DanielBaur/useless_box/images/3_4__close_up_.jpg

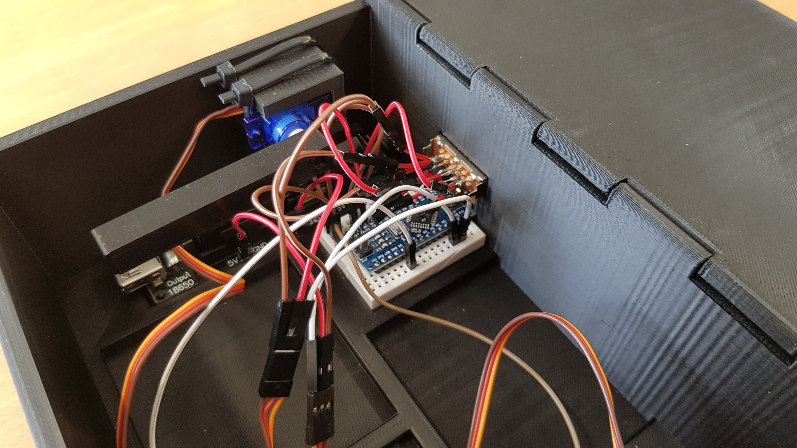
images/3_4__close_up_.jpg
