DanielBaur/useless_box/images/daniele_tartaglia__circuit_scheme_1.png

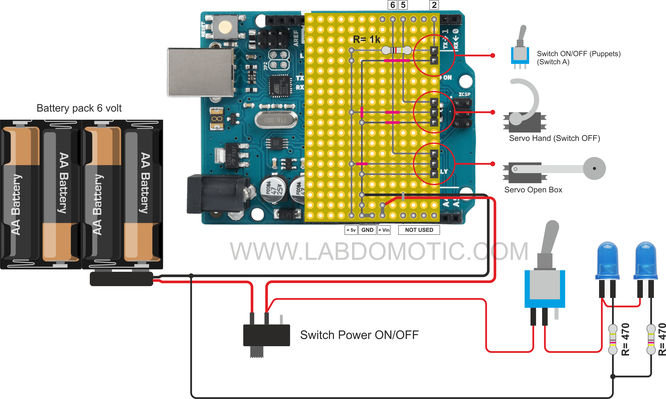
images/daniele_tartaglia__circuit_scheme_1.png
