DanielBaur/useless_box/images/daniele_tartaglia__circuit_scheme_2.png

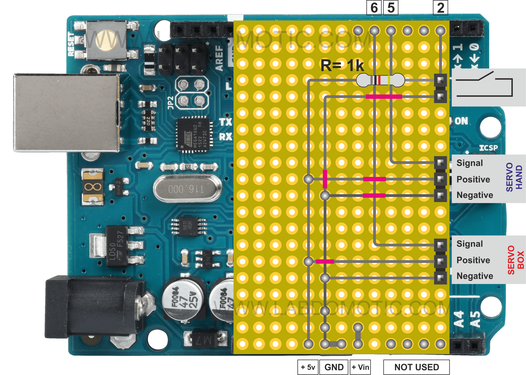
images/daniele_tartaglia__circuit_scheme_2.png
