DanielBaur/useless_box/PUPPETS_UselessBox/PUPPETS_UselessBox.ino

/* www.labdomotic.com
Youtube channel TARTAGLIA DANIELE
*/

#include <Servo.h>                        //Inserisci libreria del servo
Servo handServo;
Servo boxServo;

int switchAnimazione = 0, action = 1, vot, randNumber = 0;
const int InterruttorePorta = 2;
const int ServoManoPin = 5;
const int ServoAperturaBoxPin = 6;


void setup()
{
  Serial.begin(9600);
  handServo.attach(ServoManoPin);
  boxServo.attach(ServoAperturaBoxPin);
  handServo.write(180);   //Posizione di partenza del servomotore Mano
  boxServo.write(70);    //Posizione di partenza del servomotore che apre la scatola
}


void loop()
{
  switchAnimazione = digitalRead(InterruttorePorta);


  // ----------------------------------------------------------------------------------------------------------------------------
  // -------------------------------                  PRIMA ANIMAZIONE                -------------------------------------------
  // ----------------------------------------------------------------------------------------------------------------------------
  // ----------------------------------------------------------------------------------------------------------------------------

  if (switchAnimazione == LOW) {

    if (action == 1)
    {
      for (int i = 70; i <= 110; i++)
      {
        boxServo.write(i);
        delay(13);
      }
      for (int i = 180; i >= 35; i--)
      {
        handServo.write(i);
        delay(20);
      }
      delay(1000);
      handServo.write(26);
      delay(200);
      for (int i = 26; i <= 180; i++)
      {
        handServo.write(i);
        delay(20);
      }
      for (int i = 110; i >= 70; i--)
      {
        boxServo.write(i);
        delay(20);
      }
      action++;
    }

    // ----------------------------------------------------------------------------------------------------------------------------
    // -------------------------------                  SECONDA ANIMAZIONE                -----------------------------------------
    // ----------------------------------------------------------------------------------------------------------------------------
    // ----------------------------------------------------------------------------------------------------------------------------


    else if (action == 2)
    {
      for (int i = 70; i <= 110; i++) {
        boxServo.write(i);
        delay(6);
      }
      delay(550);
      handServo.write(26);
      delay(550);
      handServo.write(180);
      delay(550);
      boxServo.write(70);
      delay(1500);
      for (int i = 70; i <= 110; i++) {
        boxServo.write(i);
        delay(6);
      }
      delay(3000);
      boxServo.write(70);
      action++;
    }

    // ----------------------------------------------------------------------------------------------------------------------------
    // -------------------------------                  TERZA ANIMAZIONE                -------------------------------------------
    // ----------------------------------------------------------------------------------------------------------------------------
    // ----------------------------------------------------------------------------------------------------------------------------



    else if (action == 3)
    {
      Serial.println("Action 3");
      for (int i = 70; i <= 110; i++) {
        boxServo.write(i);
        delay(6);
      }
      delay(1000);
      boxServo.write(70);
      delay(2000);
      for (int i = 70; i <= 110; i++) {
        boxServo.write(i);
        delay(6);
      }
      handServo.write(26);
      delay(550);
      handServo.write(180);
      delay(500);
      boxServo.write(70);
      action++;
    }

    // ----------------------------------------------------------------------------------------------------------------------------
    // -------------------------------                  QUARTA ANIMAZIONE                ------------------------------------------
    // ----------------------------------------------------------------------------------------------------------------------------
    // ----------------------------------------------------------------------------------------------------------------------------



    else if (action == 4)
    {
      Serial.println("Action 4");
      for (int i = 70; i <= 110; i++)
      {
        boxServo.write(i);
        delay(20);
      }
      for (int i = 180; i >= 35; i--)
      {
        handServo.write(i);
        delay(20);
      }
      delay(2000);
      handServo.write(26);
      delay(200);
      handServo.write(180);
      delay(400);
      boxServo.write(70);
      action++;
    }


    // ----------------------------------------------------------------------------------------------------------------------------
    // -------------------------------                  QUINTA ANIMAZIONE                ------------------------------------------
    // ----------------------------------------------------------------------------------------------------------------------------
    // ----------------------------------------------------------------------------------------------------------------------------


    else if (action == 5)
    {
      Serial.println("Action 5");
      for (int i = 70; i <= 110; i++) {
        boxServo.write(i);
        delay(6);
      }
      delay(2000);
      handServo.write(65);
      delay(550);
      handServo.write(40);
      delay(200);
      handServo.write(65);
      delay(200);
      handServo.write(40);
      delay(200);
      handServo.write(65);
      delay(200);
      handServo.write(40);
      delay(200);
      handServo.write(65);
      delay(200);
      handServo.write(40);
      delay(200);
      handServo.write(65);
      delay(200);
      handServo.write(40);
      delay(200);
      handServo.write(65);
      delay(2000);
      handServo.write(26);
      delay(400);
      handServo.write(180);
      delay(400);
      boxServo.write(70);
      action++;
    }


    // ----------------------------------------------------------------------------------------------------------------------------
    // -------------------------------                  SESTA ANIMAZIONE                -------------------------------------------
    // ----------------------------------------------------------------------------------------------------------------------------
    // ----------------------------------------------------------------------------------------------------------------------------

    else if (action == 6)
    {
      Serial.println("Action 6");

      for (int i = 70; i < 110; i++)
      {
        boxServo.write(i);
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
        boxServo.write(i);
        delay(6);
      }
      delay(4000);
      boxServo.write(110);
      handServo.write(26);
      delay(650);
      handServo.write(180);
      delay(500);
      boxServo.write(100);
      delay(4000);
      boxServo.write(70);
      action++;
    }

    else if (action == 15)
    {
      Serial.println("Action 15");
      for (int i = 70; i <= 105; i++) {
        boxServo.write(i);
        delay(6);
      }
      delay(1000);
      for (int i = 0; i < 3; i++)
      {
        for (int j = 70; j <= 105; j++) {
          boxServo.write(j);
          delay(50);
        }
        for (int j = 105; j >= 70; j--)
        {
          boxServo.write(j);
          delay(50);
        }
      }
      for (int j = 70; j <= 110; j++) {
        boxServo.write(j);
        delay(50);
      }
      for (int i = 180; i >= 35; i--)
      {
        handServo.write(i);
        delay(40);
      }
      delay(1000);
      handServo.write(26);
      delay(400);
      handServo.write(180);
      delay(400);
      boxServo.write(70);
      action = 1;
    }

  }

}
